juwon1113/AGV-Logistics-Firmware/firmware/AGV_Control.ioc

Mcu.UserName=STM32F767ZITx
PA0/WKUP.GPIO_Label=STEP_PWM
PA0/WKUP.Signal=S_TIM2_CH1_ETR
PA13.GPIO_Label=TMS
PA13.Signal=SYS_JTMS-SWDIO
PA14.GPIO_Label=TCK
PA14.Signal=SYS_JTCK-SWCLK
PB0.GPIO_Label=LD1 [Green]
PB0.Signal=GPIO_Output
PB14.GPIO_Label=LD3 [Red]
PB14.Signal=GPIO_Output
PB15.GPIO_Label=MOTOR_L_DIR
PB15.Signal=GPIO_Output
PB4.GPIO_Label=ENCODER_L_A
PB4.Signal=S_TIM3_CH1
PB5.GPIO_Label=ENCODER_L_B
PB5.Signal=S_TIM3_CH2
PB6.GPIO_Label=ENCODER_R_A
PB6.Signal=S_TIM4_CH1
PB7.GPIO_Label=LD2 [Blue]
PB7.Signal=GPIO_Output
PB8.Signal=I2C1_SCL
PB9.Signal=I2C1_SDA
PC13.GPIO_Label=USER_Btn [B1]
PC13.Signal=GPXTI13
PC14/OSC32_IN.Signal=RCC_OSC32_IN
PC15/OSC32_OUT.Signal=RCC_OSC32_OUT
PC6.GPIO_Label=MOTOR_L_PWM
PC6.Signal=S_TIM8_CH1
PD13.GPIO_Label=ENCODER_R_B
PD13.Signal=S_TIM4_CH2
PD14.GPIO_Label=STEP_DIR
PD14.Signal=GPIO_Output
PD15.GPIO_Label=STEP_EN
PD15.Signal=GPIO_Output
PD5.Signal=USART2_TX
PD6.Signal=USART2_RX
PD8.GPIO_Label=STLK_RX [STM32F103CBT6_PA3]
PD8.Signal=USART3_TX
PD9.GPIO_Label=STLK_TX [STM32F103CBT6_PA2]
PD9.Signal=USART3_RX
PE9.GPIO_Label=MOTOR_R_PWM
PE9.Signal=S_TIM1_CH1
PF13.GPIO_Label=MOTOR_R_DIR
PF13.Signal=GPIO_Output
PH0/OSC_IN.GPIO_Label=MCO [STM32F103CBT6_PA8]
PH0/OSC_IN.Signal=RCC_OSC_IN
PH1/OSC_OUT.Signal=RCC_OSC_OUT
