juwon1113/AGV-Logistics-Firmware/(commit log)

2026-10-02 졸업작품 AGV 펌웨어 정리
    - 로봇1, 로봇2 메인 펌웨어 주석 정리
    - BNO055 캘리브레이션 펌웨어 추가
2026-10-02 Update README with motor details and future improvements
    Add details about the stepper motor and future improvements.
2026-10-04 Clarify vision system and debugging details in README
    Updated the README to clarify the use of NoIR camera and detailed debugging process with the marker recognition program.
2026-10-04 Enhance README with ArUco marker detection info
    Added details about ArUco marker detection using a NoIR camera and optimization techniques.
2026-10-13 setup.md 추가
